ferrophile/elec3300/images/fromEmmett1.jpeg

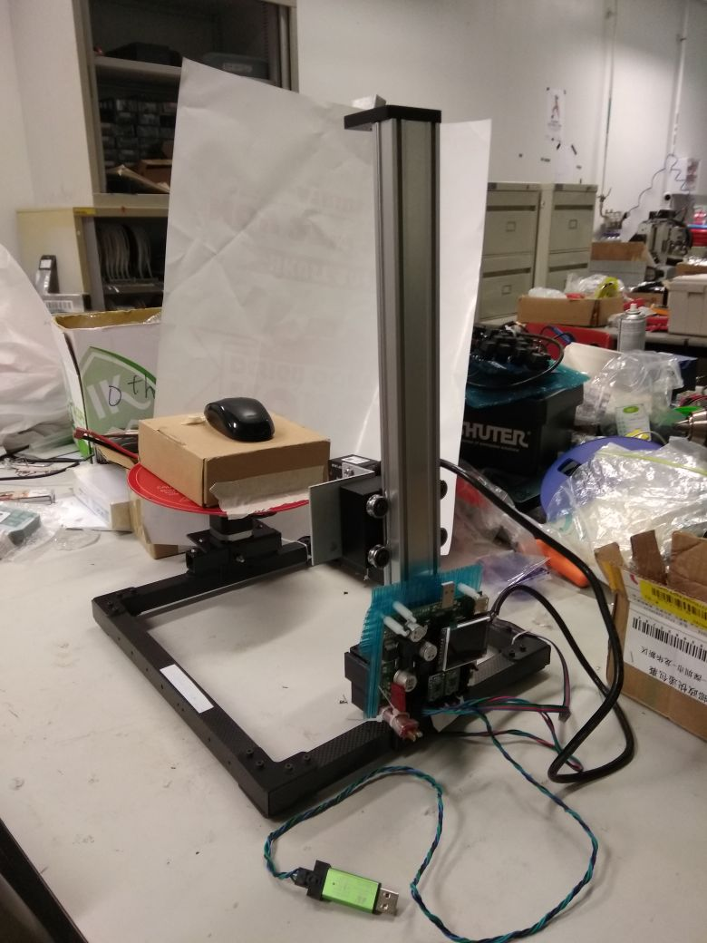
images/fromEmmett1.jpeg
