ferrophile/elec3300/images/fromEmmett2.jpeg

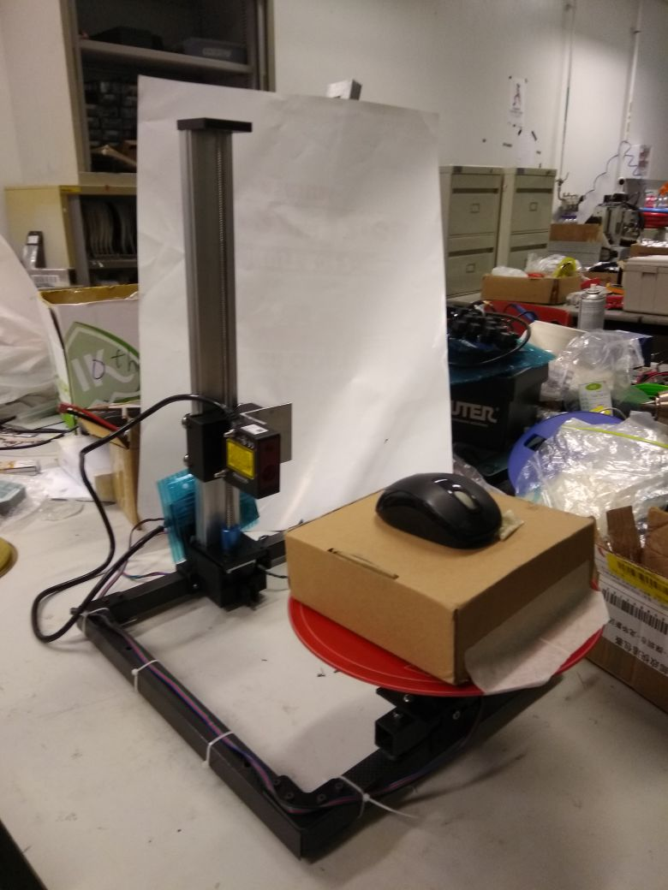
images/fromEmmett2.jpeg
