ferrophile/elec3300/README.md

# elec3300

Group 24, ELEC3300 Fall 2017

[https://ferrophile.github.io/elec3300/](https://ferrophile.github.io/elec3300/)
