ferrophile/elec3300/3d_Tests/test.stl

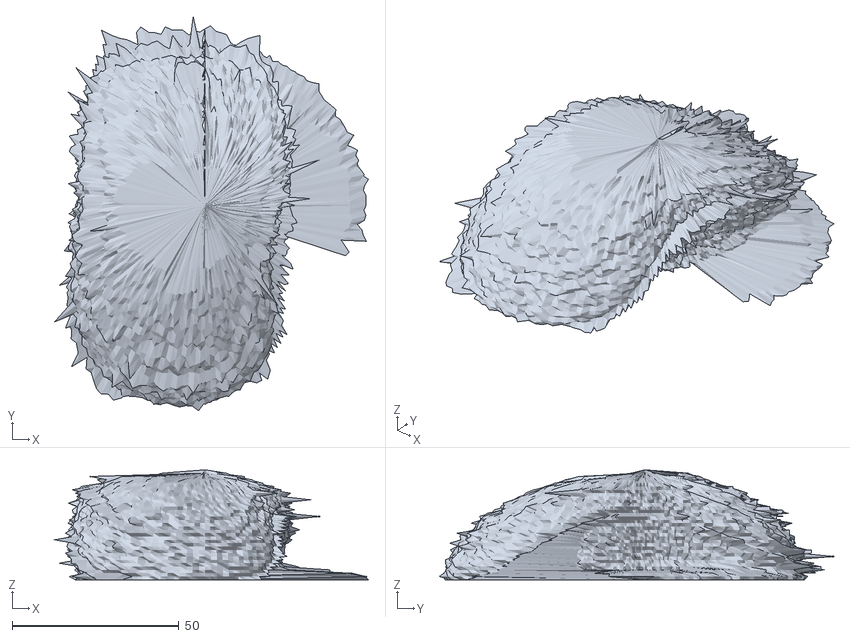
[picture p11: CAD file, 2017-12-06]
3d_Tests/test.stl
94.1 x 118.3 x 35.0
