ferrophile/elec3300/3d_Tests/scan.stl

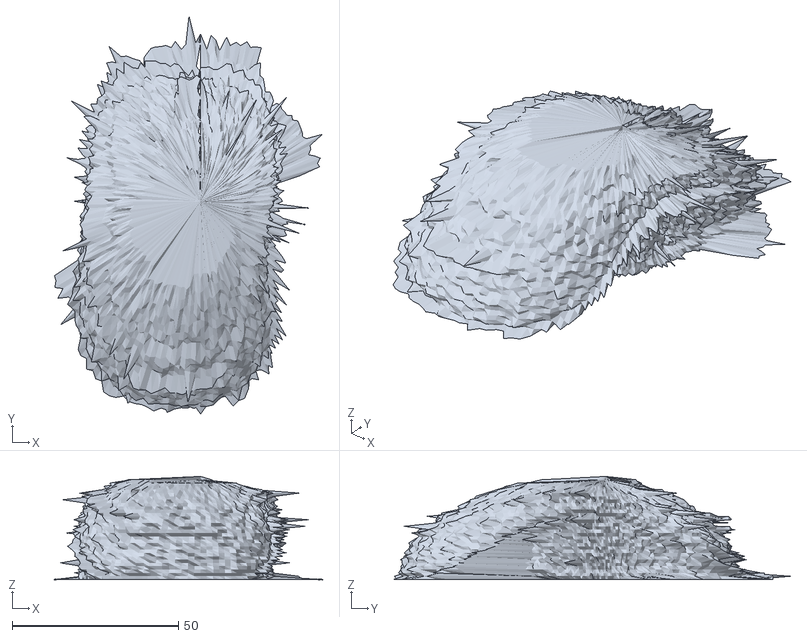
[picture p12: CAD file, 2017-11-30]
3d_Tests/scan.stl
80.6 x 119.6 x 34.0
