ferrophile/elec3300/3d_Tests/processed.stl

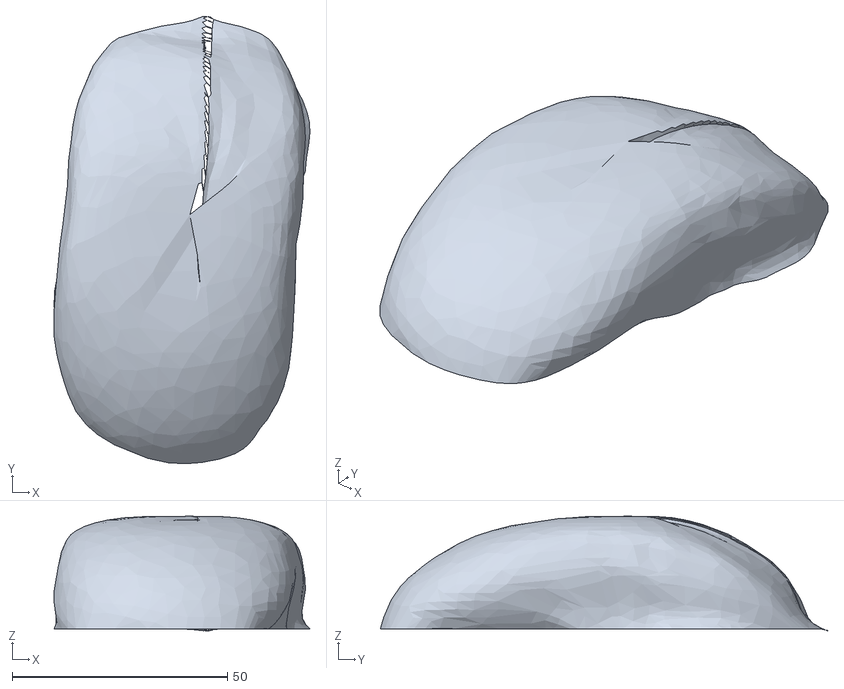
[picture p13: CAD file, 2017-11-30]
3d_Tests/processed.stl
59.5 x 104.0 x 26.6
