ferrophile/elec3300/3d_Tests/stapler.stl

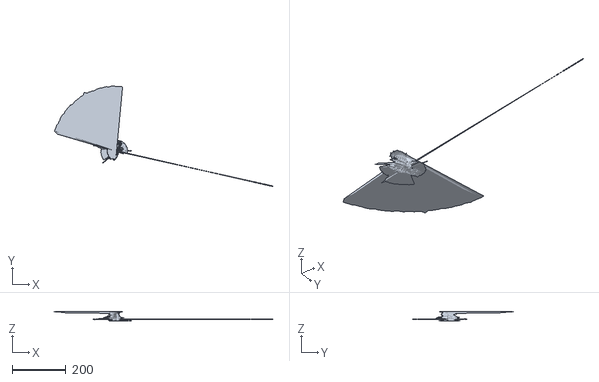
[picture p14: CAD file, 2017-11-30]
3d_Tests/stapler.stl
814.4 x 375.0 x 36.0
