ferrophile/elec3300/3d_Tests/cube_binary.stl

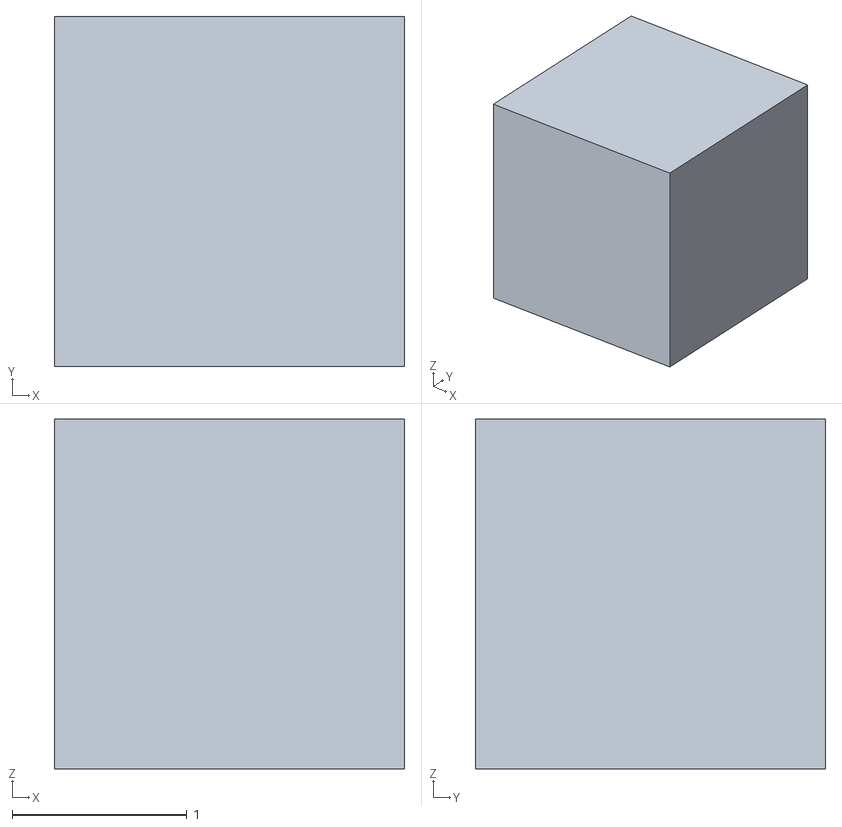
[picture p15: CAD file, 2017-10-21]
3d_Tests/cube_binary.stl
2.00 x 2.00 x 2.00
