ferrophile/elec3300/(list of files, cad)

Other CAD files:
3d_Tests/demo.blend
