ferrophile/elec3300/Scheme.PDF

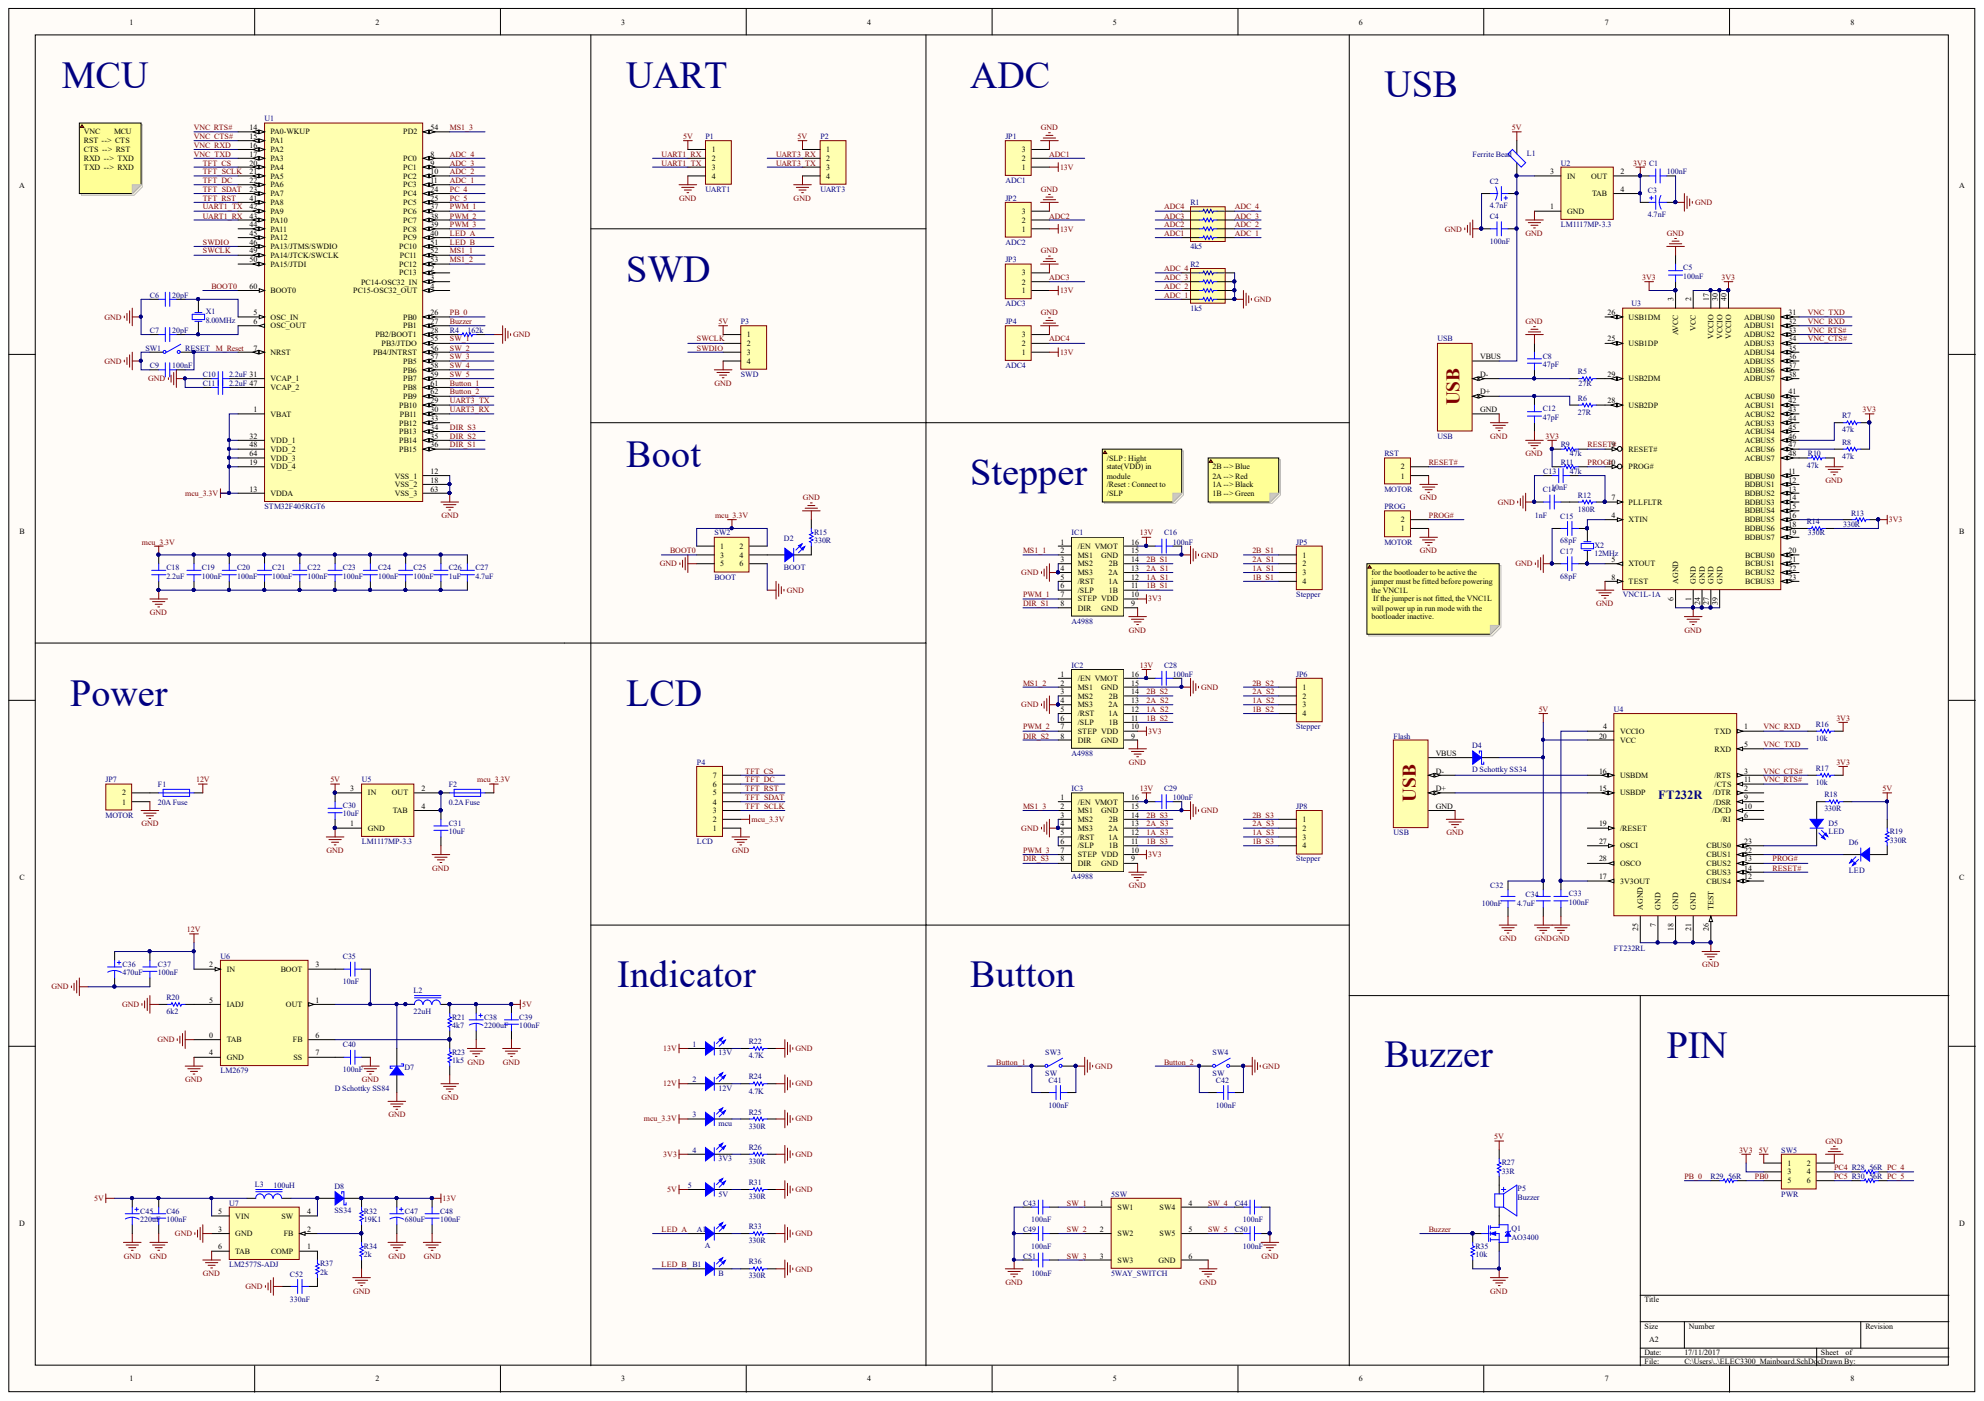
[picture p16: page 1]

for the bootloade
jumpe
r must be
the VNC1L If the jumpe
