ferrophile/elec3300/STM32F405RG/User/stepper.c

#include "stepper.h"

// List of steppers.
static Stepper stepperList[STEPPER_COUNT];

// This specifies the no. of timer counts for a trigger pulse.
static const u8 triggerPulseCount = 2; // 6 us
static const u16 countsPerRevolution = 200;

static void stepper_gpio_init(void) {
	RCC_AHB1PeriphClockCmd(RCC_AHB1Periph_GPIOB | RCC_AHB1Periph_GPIOC, ENABLE);
	
	GPIO_InitTypeDef GPIO_InitStruct;
	GPIO_InitStruct.GPIO_Speed = GPIO_Speed_50MHz;
	GPIO_InitStruct.GPIO_OType = GPIO_OType_PP;
	GPIO_InitStruct.GPIO_PuPd = GPIO_PuPd_NOPULL;
	
	// STEP Pin
	GPIO_InitStruct.GPIO_Pin = GPIO_Pin_6 | GPIO_Pin_7 | GPIO_Pin_8;
	GPIO_InitStruct.GPIO_Mode = GPIO_Mode_AF;
	GPIO_Init(GPIOC, &GPIO_InitStruct);
	
	// DIR Pin
	GPIO_InitStruct.GPIO_Pin = GPIO_Pin_13 | GPIO_Pin_14 | GPIO_Pin_15;
	GPIO_InitStruct.GPIO_Mode = GPIO_Mode_OUT;
	GPIO_Init(GPIOB, &GPIO_InitStruct);
	
	GPIO_PinAFConfig(GPIOC, GPIO_PinSource6, GPIO_AF_TIM3);
	GPIO_PinAFConfig(GPIOC, GPIO_PinSource7, GPIO_AF_TIM3);
	GPIO_PinAFConfig(GPIOC, GPIO_PinSource8, GPIO_AF_TIM3);
	
	GPIO_ResetBits(GPIOB, GPIO_Pin_13 | GPIO_Pin_14 | GPIO_Pin_15);
}

static void stepper_timer_init(void) {
	RCC_APB1PeriphClockCmd(RCC_APB1Periph_TIM3, ENABLE);
	TIM_TimeBaseInitTypeDef TIM_TimeBaseStruct;
	TIM_TimeBaseStruct.TIM_Prescaler = 503; // 3us per count
	TIM_TimeBaseStruct.TIM_CounterMode = TIM_CounterMode_Up;
	TIM_TimeBaseStruct.TIM_Period = 0xFFFF;
	TIM_TimeBaseStruct.TIM_ClockDivision = TIM_CKD_DIV1;
	TIM_TimeBaseInit(TIM3, &TIM_TimeBaseStruct);
	
	TIM_OCInitTypeDef TIM_OCInitStruct;
	TIM_OCInitStruct.TIM_OCMode = TIM_OCMode_Inactive;
	TIM_OCInitStruct.TIM_OutputState = TIM_OutputState_Enable;
	TIM_OCInitStruct.TIM_Pulse = 0;
	TIM_OCInitStruct.TIM_OCPolarity = TIM_OCPolarity_High;
	
	TIM_OC1Init(TIM3, &TIM_OCInitStruct);
	TIM_OC1PreloadConfig(TIM3, ENABLE);
	TIM_SetCompare1(TIM3, 0);
	TIM_ITConfig(TIM3, TIM_IT_CC1, DISABLE);

	TIM_OC2Init(TIM3, &TIM_OCInitStruct);
	TIM_OC2PreloadConfig(TIM3, ENABLE);
	TIM_SetCompare2(TIM3, 0);
	TIM_ITConfig(TIM3, TIM_IT_CC2, DISABLE);
	
	TIM_OC3Init(TIM3, &TIM_OCInitStruct);
	TIM_OC3PreloadConfig(TIM3, ENABLE);
	TIM_SetCompare3(TIM3, 0);
	TIM_ITConfig(TIM3, TIM_IT_CC3, DISABLE);
	
	TIM_Cmd(TIM3, ENABLE);
}

static void stepper_nvic_init(void) {
	NVIC_InitTypeDef NVIC_InitStruct;
	NVIC_InitStruct.NVIC_IRQChannel = TIM3_IRQn;
	NVIC_InitStruct.NVIC_IRQChannelPreemptionPriority = 0;
	NVIC_InitStruct.NVIC_IRQChannelSubPriority = 1;
	NVIC_InitStruct.NVIC_IRQChannelCmd = ENABLE;
	NVIC_Init(&NVIC_InitStruct);
}

static void stepper_set_dir_pin(u8 id, s16 vel) {
	if (vel > 0) {
		if (id == STEPPER_1) GPIO_SetBits(GPIOB, GPIO_Pin_15);
		if (id == STEPPER_2) GPIO_SetBits(GPIOB, GPIO_Pin_14);
		if (id == STEPPER_3) GPIO_SetBits(GPIOB, GPIO_Pin_13);
	} else if (vel < 0) {
		if (id == STEPPER_1) GPIO_ResetBits(GPIOB, GPIO_Pin_15);
		if (id == STEPPER_2) GPIO_ResetBits(GPIOB, GPIO_Pin_14);
		if (id == STEPPER_3) GPIO_ResetBits(GPIOB, GPIO_Pin_13);
	}
}

static u32 stepper_get_pulse_count(s16 vel) {
	if (vel == 0)
		return 0;
	
	// Steps per revolution = 200
	// Frequency of pulses = RPM * 200 / 60
	// Period of pulses = 60 / (RPM * 200)
	// Period of timer count = 504 / 168E6 = 3E-6 (3us)
	// No. of counts per pulse = 60 / (RPM * 200 * 3E-6) = 1E5 / RPM
	
	u32 countsPerPulse = 100000 / ABS(vel);
	return countsPerPulse - triggerPulseCount;
}

void stepper_init(void) {
	Stepper stepper;
	
	for (u8 i = 0; i < STEPPER_COUNT; i++) {
		stepper.velocity = 0;
		stepper.pulseState = 0;
		stepper.countsBetweenPulses = 0;
		stepper.setVelocityFlag = 0;
		stepper.stepCount = 0;
		stepper.targetStepCount = 0;
		stepper.handler = 0;
		
		stepper.channel = 4 * i;
		stepper.interruptChannel = TIM_IT_CC1 << i;
		if (i == STEPPER_1) stepper.setCompareFunc = TIM_SetCompare1;
		if (i == STEPPER_2) stepper.setCompareFunc = TIM_SetCompare2;
		if (i == STEPPER_3) stepper.setCompareFunc = TIM_SetCompare3;
		
		stepperList[i] = stepper;
	}
	
	stepper_gpio_init();
	stepper_timer_init();
	stepper_nvic_init();
}

void stepper_set_handler(u8 id, StepHandler newHandler) {
	Stepper * stepper = stepperList + id;
	stepper->handler = newHandler;
}

s16 stepper_get_vel(u8 id) {
	Stepper * stepper = stepperList + id;
	return stepper->velocity;
}

Stepper * stepper_get_params(u8 id) {
	return stepperList + id;
}

u32 stepper_get_count(u8 id) {
	Stepper * stepper = stepperList + id;
	return stepper->stepCount;
}

u8 stepper_is_idle(u8 id) {
	Stepper * stepper = stepperList + id;
	return (stepper->stepCount == stepper->targetStepCount);
}

void stepper_set_vel(u8 id, s16 vel) {
	Stepper * stepper = stepperList + id;
	
	if (stepper->velocity == 0) {
		if (vel != 0) {
			// Start moving - generate a pulse next count
			u16 nextCount = TIM_GetCounter(TIM3) + 5;
			
			stepper_set_dir_pin(id, vel);
			(stepper->setCompareFunc)(TIM3, nextCount);
			TIM_SelectOCxM(TIM3, stepper->channel, TIM_OCMode_Toggle);
			TIM_CCxCmd(TIM3, stepper->channel, TIM_CCx_Enable);
			TIM_ITConfig(TIM3, stepper->interruptChannel, ENABLE);
		}
	} else {
		// Already moving - wait for next pulse to change
		stepper->setVelocityFlag = 1;
	}

	stepper->velocity = vel;
	stepper->countsBetweenPulses = stepper_get_pulse_count(vel);
	stepper->targetStepCount = stepper->stepCount;
}

void stepper_set_deg(u8 id, s16 vel, u32 degree) {
	Stepper * stepper = stepperList + id;
	
	u32 counts = degree * countsPerRevolution / 360;
	stepper_set_vel(id, vel);
	stepper->targetStepCount = stepper->stepCount + counts * SIGN(vel);
}

void TIM3_IRQHandler(void) {
	for (u8 i = 0; i < STEPPER_COUNT; i++) {
		Stepper * stepper = stepperList + i;
		u16 interruptChannel = stepper->interruptChannel;
		if (TIM_GetITStatus(TIM3, interruptChannel)) {
			// TIM3_CHx pins (STEP pins) will be automatically toggled by hardware.
			// This section only changes TIM3_CCRx registers to schedule the next toggle.
			// There is no need for modulus, since TIM3_ARR is set to 2^16-1 so
			// unsigned 16-bit addition and overflow should be correct.
			
			if (stepper->pulseState) {
				// Update step count using current direction
				stepper->stepCount += SIGN(stepper->velocity);
				if (stepper->stepCount == stepper->targetStepCount)
					stepper_set_vel(i, 0);
				
				// Update velocity control
				if (stepper->setVelocityFlag) {
					if (stepper->velocity == 0) {
						// Change to zero velocity, so stop interrupts
						TIM_ITConfig(TIM3, stepper->interruptChannel, DISABLE);
						TIM_SelectOCxM(TIM3, stepper->channel, TIM_OCMode_Inactive);
					} else {
						// Need to change directions only (countsBetweenPulses already updated)
						stepper_set_dir_pin(i, stepper->velocity);
					}
					
					// Clear flag
					stepper->setVelocityFlag = 0;
				}
				
				// Run handler (if any)
				if (stepper->handler)
					(stepper->handler)();
				
				// Falling edge; pin will be pulled down, wait for period until next pulse
				u32 nextCount = stepper->countsBetweenPulses;
				(stepper->setCompareFunc)(TIM3, TIM_GetCounter(TIM3) + nextCount);
				stepper->pulseState = 0;
			} else {
				// Rising edge; pin will be pulled up for short pulse
				(stepper->setCompareFunc)(TIM3, TIM_GetCounter(TIM3) + triggerPulseCount);
				stepper->pulseState = 1;
			}
			
			TIM_ClearITPendingBit(TIM3, interruptChannel);
		}
	}
}
