ferrophile/elec3300/STM32F405RG/User/laser.c

#include "laser.h"

static volatile u16 reading[4] = {0};

static void laser_gpio_init(void) {
	RCC_AHB1PeriphClockCmd(RCC_AHB1Periph_GPIOC, ENABLE);
	
	GPIO_InitTypeDef GPIO_InitStruct;
	GPIO_InitStruct.GPIO_Pin = GPIO_Pin_0 | GPIO_Pin_1 | GPIO_Pin_2 | GPIO_Pin_3;
	GPIO_InitStruct.GPIO_Mode = GPIO_Mode_AN;
	GPIO_InitStruct.GPIO_Speed = GPIO_Speed_50MHz;
	GPIO_InitStruct.GPIO_OType = GPIO_OType_OD;
	GPIO_InitStruct.GPIO_PuPd = GPIO_PuPd_NOPULL;
	GPIO_Init(GPIOC, &GPIO_InitStruct);
}

static void laser_adc_init(void) {
	RCC_APB2PeriphClockCmd(RCC_APB2Periph_ADC1, ENABLE);
	RCC_AHB1PeriphClockCmd(RCC_AHB1Periph_DMA2, ENABLE);
	
	ADC_DeInit();
	
	ADC_CommonInitTypeDef ADC_CommonInitStruct;
	ADC_CommonInitStruct.ADC_Mode = ADC_Mode_Independent;
	ADC_CommonInitStruct.ADC_Prescaler = ADC_Prescaler_Div2;
	ADC_CommonInitStruct.ADC_DMAAccessMode = ADC_DMAAccessMode_Disabled;
	ADC_CommonInitStruct.ADC_TwoSamplingDelay = ADC_TwoSamplingDelay_5Cycles;
	
	ADC_InitTypeDef ADC_InitStruct;
	ADC_InitStruct.ADC_Resolution = ADC_Resolution_12b;
	ADC_InitStruct.ADC_ScanConvMode = ENABLE;
	ADC_InitStruct.ADC_ContinuousConvMode = ENABLE;
	ADC_InitStruct.ADC_ExternalTrigConvEdge = ADC_ExternalTrigConvEdge_None;
	ADC_InitStruct.ADC_ExternalTrigConv = ADC_ExternalTrigConv_T1_CC1;
	ADC_InitStruct.ADC_DataAlign = ADC_DataAlign_Right;
	ADC_InitStruct.ADC_NbrOfConversion = 4;
	
	ADC_RegularChannelConfig(ADC1, ADC_Channel_13, 1, ADC_SampleTime_480Cycles);
	ADC_RegularChannelConfig(ADC1, ADC_Channel_12, 2, ADC_SampleTime_480Cycles);
	ADC_RegularChannelConfig(ADC1, ADC_Channel_11, 3, ADC_SampleTime_480Cycles);
	ADC_RegularChannelConfig(ADC1, ADC_Channel_10, 4, ADC_SampleTime_480Cycles);
	ADC_Init(ADC1, &ADC_InitStruct);
	
	DMA_InitTypeDef DMA_InitStruct;
	DMA_InitStruct.DMA_Channel = DMA_Channel_0;
	DMA_InitStruct.DMA_PeripheralBaseAddr = (u32) &(ADC1)->DR;
	DMA_InitStruct.DMA_Memory0BaseAddr = (u32) reading;
	DMA_InitStruct.DMA_DIR = DMA_DIR_PeripheralToMemory;
	DMA_InitStruct.DMA_BufferSize = 4;
	DMA_InitStruct.DMA_PeripheralInc = DMA_PeripheralInc_Disable;
	DMA_InitStruct.DMA_MemoryInc = DMA_MemoryInc_Enable;
	DMA_InitStruct.DMA_PeripheralDataSize = DMA_PeripheralDataSize_HalfWord;
	DMA_InitStruct.DMA_MemoryDataSize = DMA_MemoryDataSize_HalfWord;
	DMA_InitStruct.DMA_Mode = DMA_Mode_Circular;
	DMA_InitStruct.DMA_Priority = DMA_Priority_High;
	DMA_InitStruct.DMA_FIFOMode = DMA_FIFOMode_Disable;
	DMA_InitStruct.DMA_FIFOThreshold = DMA_FIFOThreshold_HalfFull;
	DMA_InitStruct.DMA_MemoryBurst = DMA_MemoryBurst_Single;
	DMA_InitStruct.DMA_PeripheralBurst = DMA_PeripheralBurst_Single;
	DMA_Init(DMA2_Stream0, &DMA_InitStruct);
	DMA_Cmd(DMA2_Stream0, ENABLE);
		
	ADC_DMARequestAfterLastTransferCmd(ADC1, ENABLE);
	ADC_DMACmd(ADC1, ENABLE);
	ADC_Cmd(ADC1, ENABLE);
	ADC_SoftwareStartConv(ADC1);
}

void laser_init() {
	laser_gpio_init();
	laser_adc_init();
}

u16 laser_get_reading(u8 id) {
	return reading[id];
}

u16 laser_get_raw_value(void) {
	static u8 i = 0;
	i = (i+1) % 17;
	return i * 10 + 10;
}
