ferrophile/elec3300/(commit log)

2017-11-27 usb driver
2017-11-28 fuck this is not working out as expected
    [main.c]
2017-11-29 STL generation
